WyattMarks/ESP32_HeatController/README.md

# ESP32_HeatController

This is a PID heat controller using the ESP32. The PCB and schematics are included, as well as the software used to run it. It's still a WIP, so expect changes.
