WyattMarks/ESP32_HeatController/Model/base_open_bottom.stl

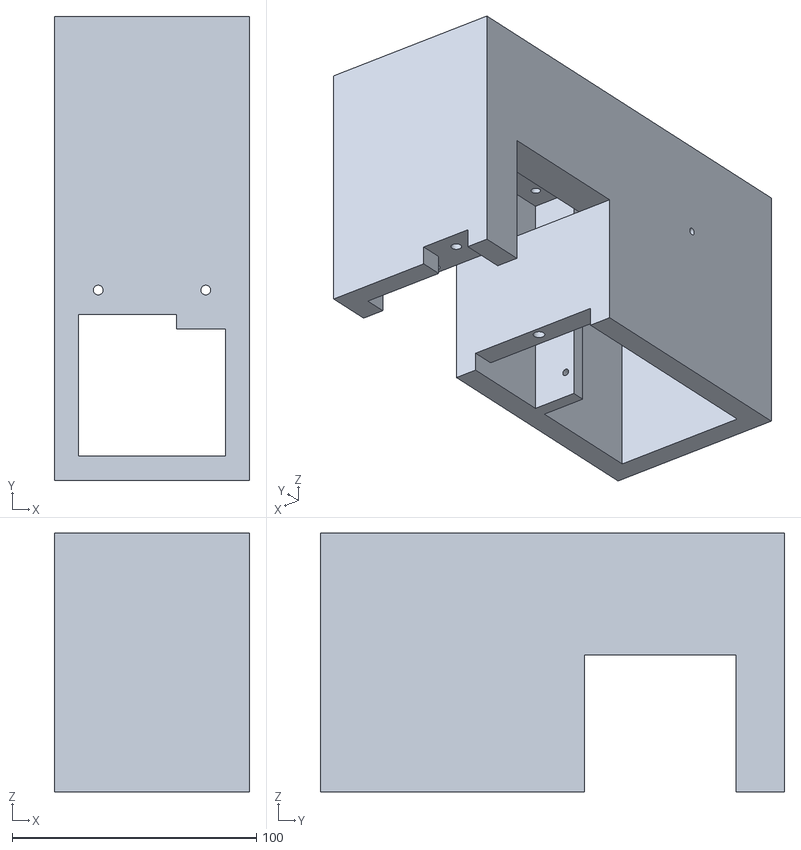
[picture p1: CAD file, 2022-02-05]
Model/base_open_bottom.stl
80.0 x 190.0 x 106.0
