WyattMarks/ESP32_HeatController/ESP32_HeatController.kicad_pcb

## KiCad design ESP32_HeatController.kicad_pcb (2022-02-03)

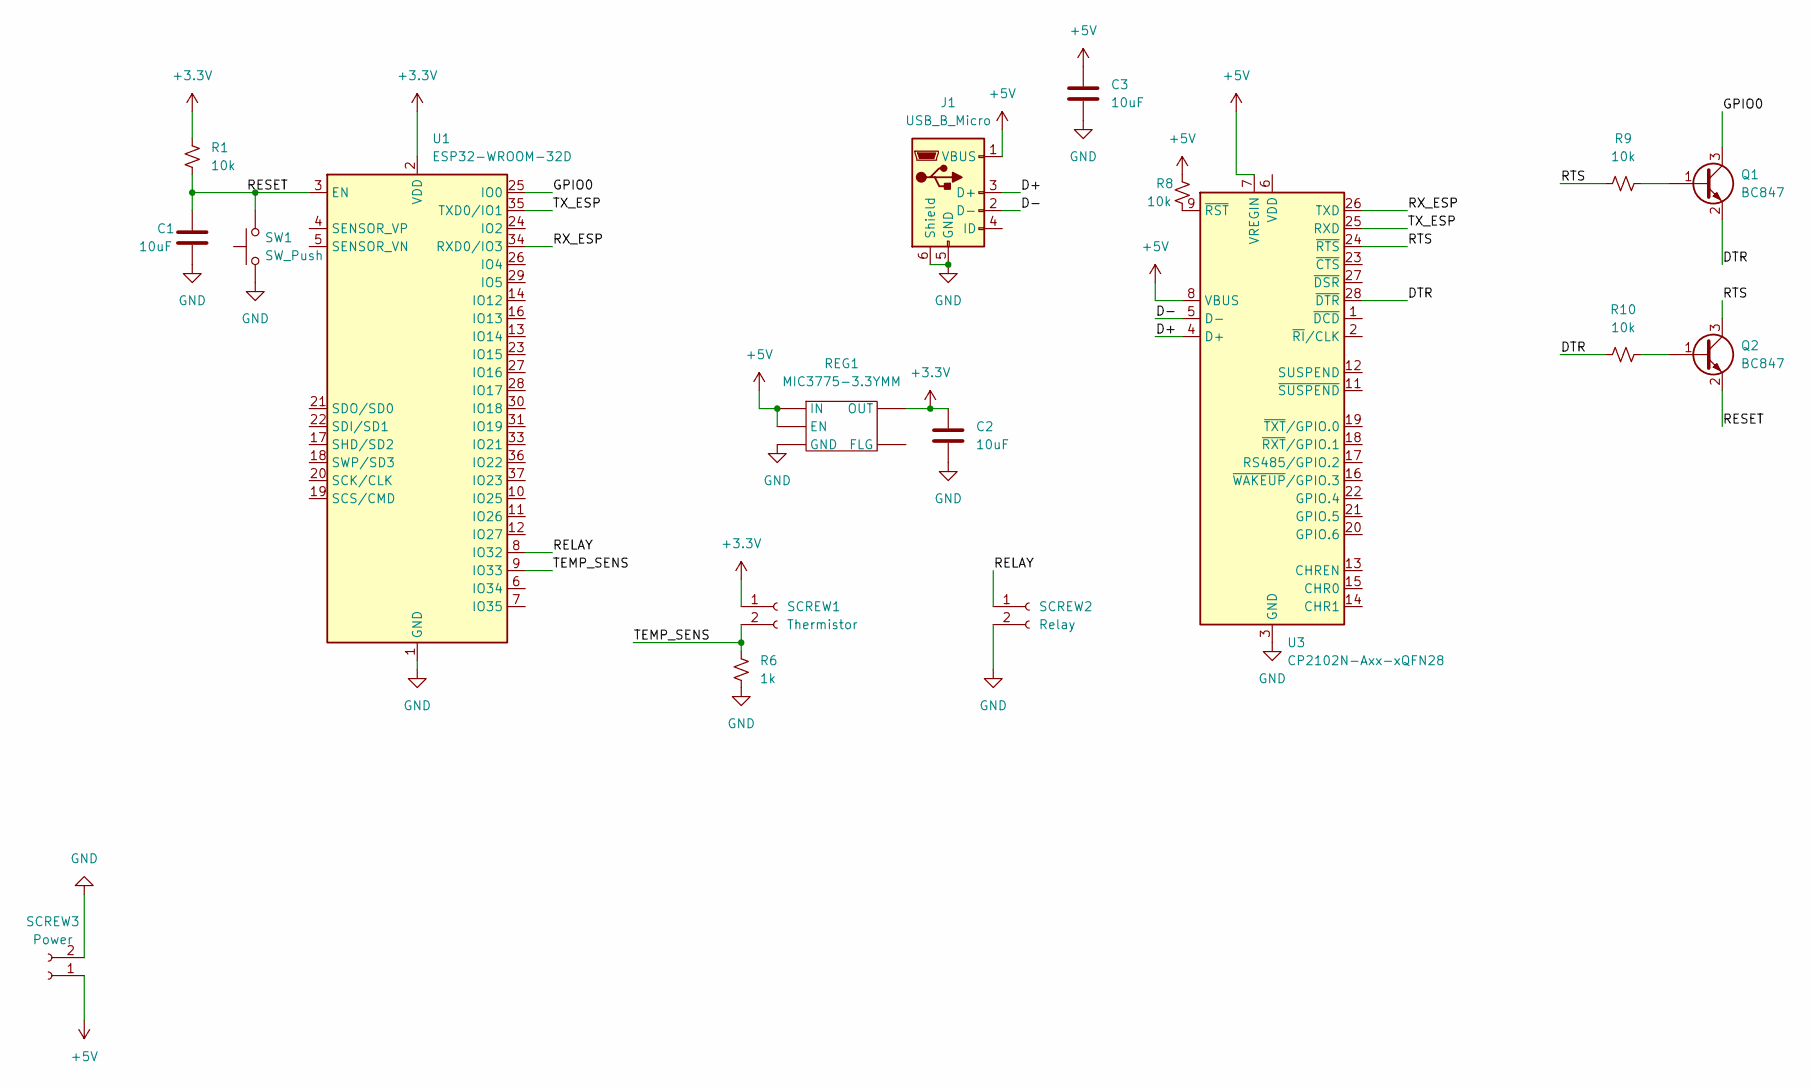
[picture p2: schematic ESP32_HeatController.kicad_sch]

Parts:
C1, C2, C3: 10uF; C_0603_1608Metric
J1: USB_B_Micro; USB_Micro-B_Amphenol_10104110_Horizontal
Q1, Q2: BC847; SOT-523
R1, R8, R9, R10: 10k; R_0603_1608Metric
R6: 1k; R_0603_1608Metric
REG1: MIC3775-3.3YMM; MSOP8-Reg
SCREW1: Thermistor; JWT_A3963_1x02_P3.96mm_Vertical
SCREW2: Relay; JWT_A3963_1x02_P3.96mm_Vertical
SCREW3: Power; JWT_A3963_1x02_P3.96mm_Vertical
SW1: SW_Push; SW_SPST_EVPBF
U1: ESP32-WROOM-32D; ESP32-WROOM-32
U3: CP2102N-Axx-xQFN28; QFN-28-1EP_5x5mm_P0.5mm_EP3.35x3.35mm

Connections:
+3V3: C2.1, R1.1, REG1.OUT, SCREW1.1, U1.2 (VDD)
+5V: C3.1, J1.1 (VBUS), R8.2, REG1.EN, REG1.IN, SCREW3.1, U3.7 (VREGIN), U3.8 (VBUS)
/D+: J1.3 (D+), U3.4 (D+)
/D-: J1.2 (D-), U3.5 (D-)
/DTR: Q1.2 (E), R10.1, U3.28 (~DTR)
/GPIO0: Q1.3 (C), U1.25 (IO0)
/RELAY: SCREW2.1, U1.8 (IO32)
/RESET: C1.1, Q2.2 (E), R1.2, SW1.2, U1.3 (EN)
/RTS: Q2.3 (C), R9.1, U3.24 (~RTS)
/RX_ESP: U1.34 (RXD0/IO3), U3.26 (TXD)
/TEMP_SENS: R6.1, SCREW1.2, U1.9 (IO33)
/TX_ESP: U1.35 (TXD0/IO1), U3.25 (RXD)
GND: C1.2, C2.2, C3.2, J1.5 (GND), J1.6 (Shield), R6.2, REG1.GND, SCREW2.2, SCREW3.2, SW1.1, U1.1 (GND), U1.15 (GND), U1.38 (GND), U1.39 (GND), U3.3 (GND), U3.29 (GND)
unnamed: Q1.1 (B), R9.2
unnamed: Q2.1 (B), R10.2
unnamed: R8.1, U3.9 (~RST)

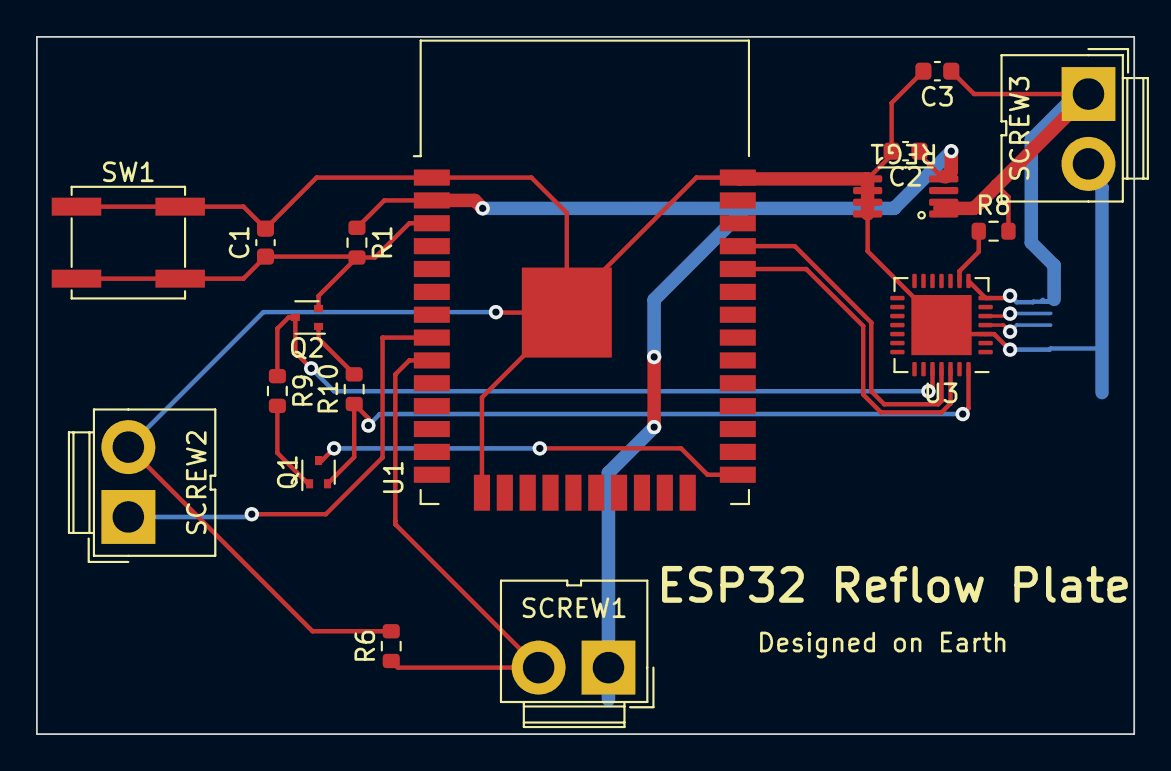
[picture p3: board ESP32_HeatController.kicad_pcb from above]

Board: 2 copper layers, 61.0 x 38.7 mm, 18 parts (1 on the bottom side), 16 nets.
