WyattMarks/ESP32_HeatController/(commit log)

2022-02-03 Initial Commit to git
    [ESP32_HeatController.kicad_pcb, ESP32_HeatController.kicad_sch]
2022-02-03 Add temperature control
2022-02-03 Added an On/Off button
2022-02-03 Small button changes
2022-02-05 Added 3D Model of the base
    [base_open_bottom.scad, base_open_bottom.stl]
